neoden/tinyfan/production/bom_pcbway.csv

Designator | Qty | Manufacturer | Mfg Part # | Description | Package | Type | LCSC Part #
C1,C2 | 2 | Yageo | CC0805KRX7R9BB104 | 100nF 50V X7R | 0805 | SMD | C49678
Q1 | 1 | Changjiang | MMBT3904 | NPN transistor | SOT-23 | SMD | C20526
R1,R2 | 2 | Uniroyal | 0805W8F1002T5E | 10K 1% | 0805 | SMD | C17414
R3 | 1 | Uniroyal | 0805W8F1001T5E | 1K 1% | 0805 | SMD | C17513
U1 | 1 | Microchip | ATTINY85-20SU | 8-bit MCU | SOIC-8 | SMD | C89852
