neoden/tinyfan/tinyfan.kicad_pcb

## KiCad design tinyfan.kicad_pcb (2026-10-11)

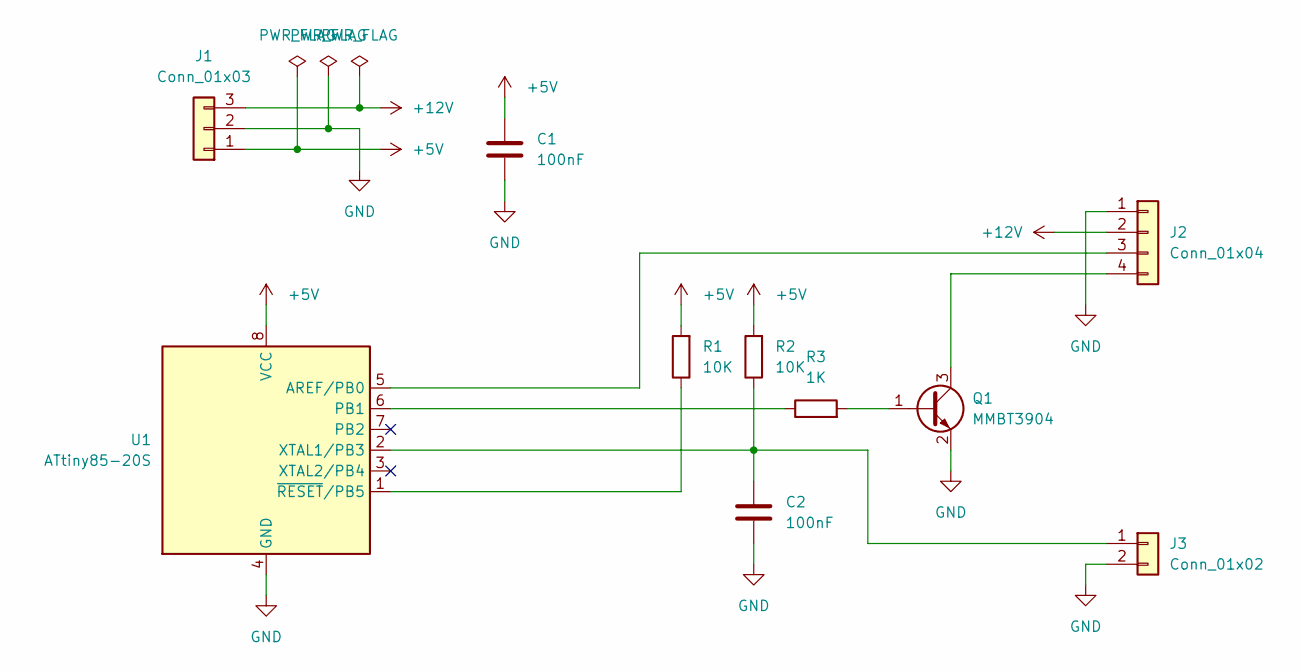
[picture p1: schematic tinyfan.kicad_sch]

Parts:
C1, C2: 100nF; C_0805_2012Metric; LCSC Part # C49678
J1: Conn_01x03; PinHeader_1x03_P2.54mm_Horizontal
J2: Conn_01x04; PinHeader_1x04_P2.54mm_Horizontal
J3: Conn_01x02; PinHeader_1x02_P2.54mm_Horizontal
Q1: MMBT3904; SOT-23; LCSC Part # C20526
R1, R2: 10K; R_0805_2012Metric; LCSC Part # C17414
R3: 1K; R_0805_2012Metric; LCSC Part # C17513
U1: ATtiny85-20S; SOIC-8_5.3x5.3mm_P1.27mm; LCSC Part # C89852

Connections:
+5V: C1.1, J1.1, R1.2, R2.2, U1.8 (VCC)
+12V: J1.3, J2.2
GND: C1.2, C2.2, J1.2, J2.1, J3.2, Q1.2 (E), U1.4 (GND)
unnamed: J2.3, U1.5 (AREF/PB0)
unnamed: J2.4, Q1.3 (C)
unnamed: C2.1, J3.1, R2.1, U1.2 (XTAL1/PB3)
unnamed: Q1.1 (B), R3.2
unnamed: R3.1, U1.6 (PB1)
unnamed: R1.1, U1.1 (~RESET/PB5)

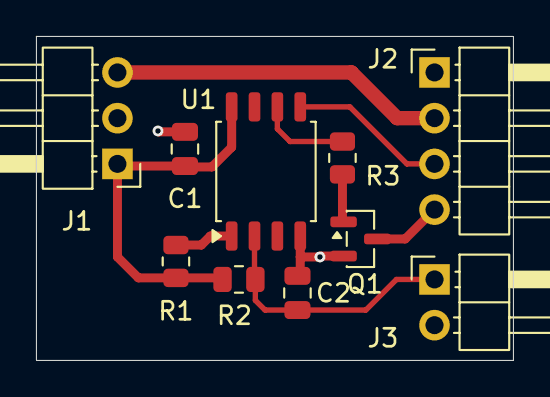
[picture p2: board tinyfan.kicad_pcb from above]

Board: 2 copper layers, 26.5 x 18.0 mm, 10 parts (0 on the bottom side), 9 nets.
