neoden/tinyfan/(commit log)

2026-10-11 Initial import: PSU fan controller (ATtiny85 + NTC), KiCad 10 project
    Schematic, board, fab outputs (gerbers, drill, BOM, pos) and a Makefile that
    regenerates them with kicad-cli. Lock files, KiCad local history and
    per-user settings are ignored.
    [bom.csv, bom_pcbway.csv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]
2026-10-11 Add ATtiny85 firmware with arduino-cli build
    Arduino sketch (ATTinyCore) with a Makefile for compile, fuses and ISP
    upload. Compared with the original Digispark version: NTC moved to
    ADC3/PB3 to match the board, watchdog cleared in .init3 to avoid a reset
    loop after a WDT reset, Timer1 prescaler derived from F_CPU, 100% duty
    handled by detaching OC1A. Comments translated to English.
    [psu_controller.ino]
2026-10-11 firmware: R_FIXED = 10k to match R2 on the board
2026-10-11 firmware: conditional integration instead of integral windup
    Stop accumulating the integral while the output is pinned at 100% and the
    error is positive. The panic branch no longer preloads the integral, so
    after an overtemperature or sensor fault the fan backs off as soon as the
    PI output allows instead of holding full speed for minutes.
    [psu_controller.ino]
2026-10-11 Rename project psu_controller -> tinyfan
    KiCad project, board and schematic files, fab outputs, firmware sketch
    and docs. Gerbers, drill, BOM and pos regenerated under the new name.
    Drop the ATTinyCore .lst listing that had slipped into the tree.
    [psu_controller-F_Cu.gtl, tinyfan-B_Cu.gbl, tinyfan-B_Mask.gbs, tinyfan-B_Paste.gbp, tinyfan-B_Silkscreen.gbo, tinyfan-Edge_Cuts.gm1, tinyfan-F_Cu.gtl, tinyfan-F_Mask.gts]
